ChenBri/claude-deck/DECISIONS.md

# claude-deck: decision log

A hand-built physical status panel for Claude Code. Lights, buttons, an animated
pixel-art screen and two analog needles, driven by Claude Code hooks.

## System

| # | Decision | Choice | Notes |
|---|---|---|---|
| 1 | Brain | Radxa ZERO 3W (RK3566, 2GB) | Full Linux. Header unpopulated, must be soldered. Amended 2026-09-23: was Raspberry Pi Zero 2 W, changed after checking eleven distributors including Israel's own official importer (piitel.co.il) and finding it out of stock everywhere, several with no restock date at all - a genuine global shortage, not a momentary gap. The Radxa is in stock on AliExpress today (an approved Radxa distributor) and is a spec upgrade, not a compromise: quad-core Cortex-A55 @ 1.6GHz vs. the Pi's A53 @ 1GHz, 2GB RAM vs. 512MB, WiFi 6/BT 5.4 vs. WiFi 4/BT 4.2. The whole pin map, the NeoPixel driver, and the power-in path had to be redone for the different SoC - see docs/HARDWARE.md. |
| 2 | PC link | USB gadget: HID keyboard + USB ethernet | Composite device. ECM for macOS, RNDIS for Windows. |
| 3 | Network | USB point-to-point only, WiFi behind a panel toggle | 10.55.0.1 to 10.55.0.2. Not on the LAN, not routable. |
| 4 | Power | Separate 5V 3A supply into PWR IN | Data port stays data-only. No backfeed, no current limits. |
| 5 | Filesystem | Read-only root with RAM overlay | Power loss can never corrupt the OS. |
| 6 | History | Third writable partition, /var/deck | Settings and stats. Written only on state transitions. |
| 7 | Shutdown | Long-press the encoder, plus a lit rocker on the back | Clean shutdown with a goodbye animation. |
| 8 | Stack | Python on the deck, TypeScript daemon on Windows and macOS | One daemon codebase, platform-specific action implementations. |
| 9 | Config | Encoder menu as the interface, YAML underneath | Regexes cannot be typed on a knob, so the menu writes the file. |

## Safety

| # | Decision | Choice |
|---|---|---|
| 10 | Button path | Daemon-verified. HID emits only F13-F20, never a printable key. |
| 11 | Approve semantics | "Approve request X", matched against what is on screen, 90s expiry. |
| 12 | Denylist | All four categories: database, destructive fs and git, infrastructure, secrets. |
| 13 | Machines | Full action set on Windows and on the Mac alike. The denylist, not a profile, is what protects production access. |
| 14 | Scrubbing | Truncate and redact before anything leaves the PC. |
| 15 | Audit | SQLite log on the PC of every deck-originated action. |

Full reasoning in [docs/SAFETY.md](docs/SAFETY.md).

## Panel

| # | Decision | Choice |
|---|---|---|
| 16 | Lamps | 5: READY, WORKING, BLOCKED, DONE, LINK |
| 17 | Legends | Backlit engraved acrylic strip, laser cut |
| 18 | Ambient | WS2812B strip for both the bezel halo and the underglow. Amended while sourcing: a circular ring does not fit a rectangular bezel, and 1m of 60/m strip covers the ~300mm halo perimeter and the ~300mm underglow with spare. |
| 19 | Meters | Two analog needles: CONTEXT and FIVE_HOUR. Amended 2026-09-21: originally CONTEXT and a vague "ACTIVITY", never actually wired to data. Redefined to CONTEXT (exact: current session's own token usage against the model's window) and FIVE_HOUR (an estimate: local token usage across the trailing 5 hours, weighted toward real cost since raw cache-read tokens massively overstate usage, against a budget you calibrate yourself, since Anthropic doesn't expose real remaining quota anywhere local). A third meter for weekly usage was considered and dropped: same estimate problem plus unverified panel space, not worth it for a number nobody can fully vouch for. See #58. |
| 20 | Display | 11.6 inch HDMI panel + driver board, 1366x768, in a recessed bezel. Amended 2026-09-22: was 2.4 inch IPS SPI, 320x240. Chen wanted a genuinely monitor-class screen (260x150-220mm), which a hobbyist SPI TFT does not make past ~4-5in - this is a real interface change (HDMI, not SPI), not just a bigger cutout. See docs/HARDWARE.md for the freed-up GPIO pins and the open question on the driver board's supply voltage. |
| 21 | Session selector | 6-position rotary switch, 1-5 plus ALL |
| 22 | Encoder | Menu, scrolling, long-press shutdown. Snake steering moved to the joystick. |
| 23 | APPROVE / DENY | 19mm illuminated metal pushbuttons, 3-6V ring LED, momentary self-reset, pre-wired. Live only when a prompt is pending. Amended while sourcing: illuminated arcade buttons were either unavailable outside bundle listings or 45mm, too large for the deck. |
| 24 | Panic | 22mm XB2-542 mushroom e-stop, 1NO1NC, **latching**. Amended while sourcing: spring-return mushrooms are not sold on AliExpress. Firmware fires on the press edge and holds an INTERRUPTED state until the twist-release, so the latched head visibly shows a killed run. Flip cover dropped as redundant. |
| 25 | Mech keys | 4: CLD (focus or launch), NEW, PLAN, MIC (push to talk) |
| 26 | Toggles | MUTE, NIGHT, AUTO-ACCEPT |
| 27 | Back panel | Panel-mount USB-C, barrel jack, lit rocker, SD cutout |

## Screen

| # | Decision | Choice |
|---|---|---|
| 28 | Style | Warm CRT phosphor UI, full-colour mascot, scanlines and slight bloom. Fixed 2026-09-27: the bloom was meant to add ~9% but pygame ignores set_alpha on BLEND_RGB_ADD blits, so it added 100% and doubled every colour (the orange palette rendered yellow). Now scaled explicitly, see `BLOOM_STRENGTH` in ui/render.py. |
| 29 | Art pipeline | Code-defined pixel grids rendered to PNG, refinable in Piskel |
| 30 | Mascot | Original starburst character, not Anthropic artwork |
| 31 | HUD | Session name, elapsed time, context bar |
| 32 | Ticker | Live tool name and target, sanitized |
| 33 | Idle dashboard | Clock, date, your name, weather from the daemon, git status of the last repo, today's totals. Superseded 2026-09-27 by #66: the same data now lives on ambient-mode cards, and the attract-mode snake is gone. |
| 34 | Games | Snake and Tetris as first-class scenes, launched from the encoder menu when idle. Joystick steers, mech keys rotate and drop, encoder push pauses. Amended 2026-09-25: 2048 and Pong added, same input conventions. All four now share a high score table (`deck/scores.py`, `${DECK_VAR}/scores.yaml`) with retro three-letter arcade-style initials entry on a qualifying game over (`deck/ui/name_entry.py`) - joystick up/down cycles the letter, left/right moves the slot, encoder push confirms. |
| 35 | DONE behaviour | Auto-clears back to READY after a few minutes |

## Sound

| # | Decision | Choice |
|---|---|---|
| 36 | Style | Chiptune blips generated in code, one per event |
| 37 | Events | Blocked, finished, error, task start and subagent spawn |
| 38 | Output | MAX98357A I2S amp, 40mm speaker, hard MUTE toggle |

## Enclosure

| # | Decision | Choice |
|---|---|---|
| 39 | Form | Retro terminal. Vertical face with a recessed CRT bezel, sloped control deck. |
| 40 | Size | 300 x 130 x 290 mm. Deck 55mm deep. Amended 2026-09-22 (twice): the original 160 x 120 x 100mm was never checked against actual component footprints. First pass: laying out real part sizes (the old 2.4in display, two 34mm meters, 5 lamps, rotary + encoder + 4 mech keys + 3 toggles + joystick + 4 Game Boy buttons + APPROVE/DENY + panic) with genuine finger-clearance came to roughly 250-280mm wide, landed on 260 x 120 x 150. Second pass: decision #20's display upgrade to an 11.6in monitor-class panel (257x144mm active area) leaves no room to flank it with the meters/lamps the way the small display's did, so those moved to a row below the screen instead, and the case grew again to fit the screen plus that row plus real bezel margin. |
| 41 | Colour | Matte black with orange accents |
| 42 | Process | FDM PETG via a print service. MJF nylon reprint later if wanted. |
| 43 | CAD | OpenSCAD, case as parametric code in this repo |
| 44 | Ballast | 3mm steel plate in the base plus rubber feet, about 1kg total |
| 45 | Fasteners | M3 brass heat-set inserts |

## Build

| # | Decision | Choice |
|---|---|---|
| 46 | Wiring | Perfboard first, custom PCB HAT as a later revision |
| 47 | Tools | Full soldering kit purchased new |
| 48 | Sourcing | AliExpress only, one order, everything at once. Case, legend strip, ballast plate and isopropyl fabricated or bought locally because they cannot be catalogue items. Amended 2026-09-23: no longer one order. AliExpress still covers the bulk (sections A-J), the genuine ICs come from Digi-Key (counterfeit risk), and the microSD from KSP (was piitel.co.il, same day - same real card, better price, physical Israeli branches; AliExpress never worked for it, fake-capacity listings only). A same-day check into moving the ICs to Farnell Israel too was reverted: no real domestic-sourcing benefit over Digi-Key (both are localized storefronts shipping internationally, not local warehouses) and it would have forced an SMD substitute for one part. Three orders, not one - see docs/BOM.md. |
| 49 | Sequencing | Software and simulator now, single order in parallel, one build when it all lands. No early partial build. |
| 50 | Budget | No hard ceiling. Landed at roughly $416 all-in including every tool, now ~$453 after the joystick, Game Boy buttons, the display's jump to an 11.6in HDMI panel (and the 12V power rework that forced), the effort dial, and the volume knob - see docs/BOM.md for the running total. |
| 51 | MIC key | Daemon receives the hotkey and invokes the OS dictation shortcut: Win+H on Windows, the configured dictation shortcut on macOS. |
| 52 | Fabrication | Local Tel Aviv print shop for the PETG case and the laser-cut legend strip, ordered after the electronics arrive so every cutout is measured. |
| 53 | Joystick | KY-023 analog thumbstick read through an ADS1115 I2C ADC, push button on the second MCP23017. Added 2026-09-21 for games and menu navigation. The deck gains a ~26mm square cutout; case width may grow to 170mm. |
| 54 | Game Boy app | PyBoy (GB/GBC) headless core, added 2026-09-21. Home-screen app alongside Settings/Snake/Tetris/2048/Pong (see #34). Draws into its own 160x144 canvas (native GB resolution), letterboxed onto the panel instead of the 160x120 canvas every other scene shares. |
| 55 | Game Boy buttons | A, B, START, SELECT: four Gateron G Pro switches with DSA keycaps, the same part already used for CLD/NEW/PLAN/MIC, not 6x6mm tactile buttons. Amended 2026-09-21: the deck is a stationary desk instrument, not something you hold, so "comfortable like a real Game Boy" means real switch travel and a real layout, not just wiring four more contacts to spare pins. A/B sit in a diagonal offset (A upper-right, B lower-left) rather than a row; START/SELECT are a smaller pair off to the side. Wired to the second MCP23017's remaining spares, no new IC. The d-pad reuses the existing joystick rather than adding a fifth control. |
| 56 | ROM handling | Never shipped in this public repo: each person drops their own legally-dumped .gb/.gbc files into firmware/roms/, which is gitignored except for its own README. Planned, not yet built: a fifth USB gadget function (mass storage, backed by a FAT image file on the writable partition, toggled from the Settings app) so ROMs can be dragged onto the deck as a drive from the connected PC instead of swapping the SD card. No hardware exists yet to build this against; see docs/HARDWARE.md. |
| 57 | Game Boy audio | No new hardware: PyBoy's emulated audio is queued onto the existing `chiptune` mixer (now stereo) through a channel it reserves so a running game's stream and the deck's own event blips never steal each other's channel. Same MAX98357A amp and speaker, same MUTE toggle. |
| 58 | Meter data source | CONTEXT and FIVE_HOUR both come from Claude Code's own local session logs under `~/.claude/projects`, the same files a tool like ccusage parses, never from an Anthropic API (none exists for this). The daemon reads the active session's own transcript for CONTEXT (exact) and scans every project's transcripts in the trailing 5 hours for FIVE_HOUR (an estimate, weighted toward Anthropic's approximate real pricing so cache reads don't dominate the number and pin the gauge at 100% within one long session, which the naive raw-token-count version did in testing). The weighting and the budget it's compared against are both best-effort and need calibrating to your own plan; see `daemon/src/enrich/usage.ts` and `DECK_FIVE_HOUR_TOKEN_BUDGET` in README.md. |
| 59 | Effort dial | A second SR16-family rotary switch (same part as the session selector, decision 21), 5 of its 6 positions wired: LOW/MEDIUM/HIGH/XHIGH/MAX. Added 2026-09-22 once the display upgrade's wider deck left real room for it. Wired to MCP23017 #2's spares, no new IC. Amended same day: what the daemon does with it is a real, confirmed mechanism, not the placeholder it started as - it types Claude Code's own `/effort <level>` slash command into the terminal (`effortSelect` in `daemon/src/actions/`), the same class of action as the existing approve/deny keystrokes. See decision 63 for `planMode()`, which had the same problem and is now fixed the same way. |
| 60 | Volume knob | A standalone panel-mount potentiometer (not the joystick's KY-023 pots), into the ADS1115's other spare channel (A2). Independent of the MUTE toggle: the knob sets the level, MUTE is a hard override to silent regardless of where it's turned. Purely local to the deck - chiptune.py's mixer, no daemon round-trip needed. Sourced 2026-09-22: RV24YN20S 10K ohm, real 24mm panel-mount part, ₪4.22 for a set of 3 with the A03 knob and dial plate included - cheaper than the placeholder guessed, with 2 spares free. |
| 61 | Speaker grille | Cosmetic: a small perforated patch either side of the lamp row, in what was otherwise dead space between the lamps and each meter. Ties the existing speaker into the retro-radio look instead of hiding it behind a blank face. No BOM cost, no new part. |
| 62 | Main power rail | 12V, not 5V. Amended 2026-09-22: sourced a real 11.6in display listing (docs/BOM.md B1, ₪145.48, Heyman Store) and confirmed its driver board wants 12V 2A, DC 5.5mm - not the 5V this whole design was built around. Rather than run two power cords into the case, one 12V input now feeds the display directly and a small buck converter steps it down to 5V for the deck/PCA9685/MCP23017s/amp, unchanged otherwise. Recommend a 12V 3A supply. Side effect: the KCD1 rocker switch's 12V-rated LED, previously dim on the 5V rail, now runs at full brightness with no mod, wired ahead of the buck converter. |
| 63 | PLAN mech key | Fixed 2026-09-23, same class of gap as decision 59's effort dial: `planMode()` sent a guessed hotkey (Alt+P / Option+P) that launched nothing real. The actual mechanism, confirmed against code.claude.com/docs/en/permission-modes, is Shift+Tab cycling the CLI's permission mode (`default` -> `acceptEdits` -> `plan` -> back to `default`, 3 presses from `auto`), which is relative to the session's current mode rather than a fixed key. The daemon now tracks each session's last-seen `permission_mode` from the hook payload (`sessions.ts`) and computes the exact Shift+Tab count in `guard.ts`; an unknown or uncyclable mode (`dontAsk`, `bypassPermissions`) sends nothing, same "don't guess a keystroke" rule as the approve button. The deck now tags the `mech_key` action with the active session id so the daemon knows whose mode to read. |
| 64 | Info rails | The 160x120 canvas letterboxed onto the 16:9 panel left two ~170px black bars. They now hold two 26x120 pixel rails at the same scale and CRT pass: left is clock, date, weather; right is state, session count, and CONTEXT/FIVE_HOUR as bars. Shown over every scene including games, so a glance always gives time and state. Rendering only, nothing in the state machine or approval path reads them. |
| 65 | Screen at night | The NIGHT toggle now dims the screen too (`night_screen`, default 0.4), not just the lamps. Quiet hours (default 01:00 to 08:00, Settings) blank the screen, but only in a calm state (READY, DONE, IDLE, OFFLINE) and only after 3 minutes without a touch. Anything that wants you or shows live work lights it regardless of the hour. Time comes from the daemon's idle payload since the board has no RTC and no internet, falling back to the deck's own clock. Blank is a black frame; the panel's backlight is still on, since the driver board exposes no control for it. |
| 66 | Ambient mode | The screen is mostly looked at while nothing needs you, so calm states get their own content. IDLE shows it straight away; READY and DONE drift into it after 60s without an event (DONE keeps its confetti first). It rotates data cards (clock, weather, today's usage, git, a 5-hour chart against even pace), 20s each, with a 60s mascot-life scene after every two; an encoder turn skips. Cards with no data are skipped, never shown empty. Rendering only: SceneManager re-decides every frame, so anything that wants you takes the screen back on the next frame, and the state machine, lamps, LEDs and approval path never see ambient mode. The daemon's idle payload grew `today` (sessions, tool calls, approvals, denials, turns, output tokens) and `five_hour_series`, from the same single transcript scan that already fed the FIVE_HOUR meter. |
| 67 | Mascot life | The mascot scene in ambient mode is one small room that changes with the local hour: coffee at a table (06-11), wandering between the plant and the window (11-15), reading (15-19), watching the night sky (19-23), asleep with floating Zs (23-06). Props are code-defined grids on the mascot's own 4px cell (#29), so the room shares one pixel grid. Every animation is a pure function of the clock, so re-entering ambient never resumes a half-finished animation. Also fixed on the way: the READY blink overrode the eye whites next to the pupils instead of the pupils themselves, so the mascot never actually closed its eyes. |
| 68 | PCA9685 output mode | Open-drain (MODE2 OUTDRV = 0), found 2026-09-27 while planning the real panel driver. The chip's logic supply must be 3.3V (its I2C pull-ups share VCC and the Radxa's pins are 3.63V max), so a totem-pole "high" is only 3.3V: lamps sinking from 5V would glow faintly when off, and the meters' 5V drive maths wouldn't hold. Open-drain makes an off channel high-impedance, so all LED loads sink cleanly from 5V; each meter gets a 1k pull-up to 5V and its duty is inverted in software. No new parts, the pull-ups come from the resistor kit. See docs/HARDWARE.md. |
| 69 | HID and HTTP pairing | Closes the gap between SAFETY rules 1 and 2: an F13 key proves a physical press but can't say which request, and the HTTP action names the request but could come from anything on the link. The daemon now runs approve, deny and the mech keys only when both halves arrive within 1s (`daemon/src/link/pairing.ts`); an unpaired half is dropped and audited. PANIC runs on either half alone, since it can only stop things. Hotkeys come from a small per-OS helper process: RegisterHotKey on Windows (tested end to end with a real F13 press), Carbon RegisterEventHotKey on macOS (written, untested until there's a Mac). `DECK_REQUIRE_HID=0` exists for the simulator only. Also fixed on the way: mech keys pressed inside a game were forwarded to Claude, so dropping a Tetris piece with NEW started a new session. |
| 70 | Deck provisioning | `deploy/`: one idempotent `setup.sh` on Radxa's Debian CLI image. The firmware runs as an unprivileged `deck` user with udev access to exactly its four device nodes, and one sudoers line for poweroff (the encoder long press now actually powers off). App and venv live on the writable DECKDATA partition at `/var/deck`, so updates (`deploy.ps1`, over the USB link) never touch the read-only root, which is overlayroot on tmpfs. The USB link's DHCP comes from systemd-networkd, one address, no router or DNS. SSH listens on the link only, keys only. WiFi and Bluetooth are rfkill-blocked at boot. The HID gadget's report descriptor declares only F13 to F20, so the host itself discards any other keycode. The setup script never partitions; the data partition is a manual step before first boot. |
| 71 | WiFi toggle | Settings > wifi radio now does something: it runs `rfkill unblock|block wifi` through a sudoers entry allowing exactly those two commands, and is re-applied at start-up because `deck-radio-off` blocks WiFi on every boot. There is no physical WiFi switch in the BOM, so non-negotiable 4 now reads "blocked at boot, on only through Settings", and the right rail wears a red frame and a WIFI tag for as long as it's on, since it's the one way the deck gets a route out. If rfkill refuses, the setting reverts rather than lying. Bluetooth stays blocked, no toggle. |

## Hardware constraints resolved

- **Pin budget.** I2S audio claims GPIO18/19/21, which kills SPI1 and PCM.
  NeoPixels therefore run on GPIO12 (PWM0) via `rpi_ws281x` as root in a systemd
  service. Display on SPI0. Lamps and both meters offloaded to a PCA9685 on I2C.
  Rotary switch, mech keys and toggles offloaded to an MCP23017. Buttons and the
  encoder stay on real GPIO for latency.
- **Logic levels.** 74AHCT125 between the deck's board and the WS2812B data line.
- **No analog output.** Meters driven by PCA9685 PWM through an RC filter with a
  calibration trimpot each.
- **Power.** 2.08A peak, so a 5V 3A supply.

Details in [docs/HARDWARE.md](docs/HARDWARE.md).
