ChenBri/claude-deck/docs/ARCHITECTURE.md

# Software architecture

```
Claude Code session(s)
   |  hooks: SessionStart, UserPromptSubmit, PreToolUse, PostToolUse,
   |         Notification, Stop, SubagentStop, PreCompact, SessionEnd
   v
hooks/emit.js  -- POST 127.0.0.1:7327 -->  daemon  (TypeScript, Win + macOS)
                                              |  scrub, classify, aggregate
                                              |  HTTP over USB ethernet 10.55.0.1
                                              v
                                    firmware (Python, Radxa ZERO 3W)
                                              |
                              panel backend: real  |  sim
```

## Daemon, TypeScript, runs on Windows and macOS

One codebase, one binary per platform, same behaviour. Responsibilities:

- **Ingest.** Local HTTP endpoint the hook scripts POST to. Hooks stay trivial
  one-liners so they add no measurable latency to your session.
- **Scrub.** Truncate and redact before anything leaves the machine. See SAFETY.md.
- **Classify.** Map raw events onto deck states. Run the denylist over pending
  permission requests and mark each approvable or not.
- **Aggregate.** Track every live session. Serve either the one the rotary switch
  selects, or the highest-priority state across all of them when set to ALL.
- **Act.** Receive button events, verify them against the rules, then focus the
  right window and perform the action. Windows via Win32 calls, macOS via
  AppleScript and Accessibility.
- **Enrich.** Push weather, clock and git status for the idle dashboard, since
  the deck has no internet.
- **Audit.** SQLite log of every action the deck took.

```
daemon/src/
  index.ts          bootstrap, host detection for the action backend
  http.ts           hook ingest endpoint
  scrub.ts          redaction and truncation
  classify.ts       event -> state, denylist evaluation
  sessions.ts       multi-session registry and priority
  guard.ts          approval verification rules
  link/
    transport.ts    HTTP to the deck over the USB link
    hotkeys.ts      F13-F20 global hotkey registration
  actions/
    windows.ts      focus, send keys, launch
    macos.ts        same, via osascript
  enrich/           weather, git status, Claude Code's own local usage logs (the two meters)
  store.ts          SQLite audit log
```

## Firmware, Python, runs on the deck

```
firmware/deck/
  main.py             event loop
  state.py            state machine, priority, latching, timeouts
  link.py             talks to the daemon, heartbeat drives the LINK lamp
  hid.py              USB HID gadget writer, F13-F20 only (SAFETY.md rule 1)
  menu.py             encoder-driven settings menu, writes /var/deck/settings.yaml
  hwtest.py           bench bring-up: live input readout, output sweep (Settings)
  calibration.py      per-meter 5-point needle curve and its wizard (Settings)
  screen.py           NIGHT dimming, quiet-hours blanking, daemon-sourced wall clock
  panel/
    base.py           abstract Panel: lamps, meters, pixels, inputs, screen surface
    real.py           wires the hw/ drivers to docs/HARDWARE.md's pins and channels
    hw/               PCA9685 (open-drain), MCP23017, ADS1115, WS2812-over-SPI,
                      gpiod edges; input decoding kept pure and tested with fakes
    sim.py            pygame window drawing the whole panel on your desktop
  ui/
    render.py         scene compositor, dirty-rect blitting, CRT post effect
    rails.py          clock/weather and state/meter rails in the letterbox bars
    cards.py          ambient data cards: clock, weather, today, git, 5-hour chart
    sprites.py        code-defined pixel grids -> PNG sprite sheets
    scenes/
      ready.py        sits, blinks, stretches
      working.py      types at a tiny desk, glyphs fly, speed tracks tool-call rate
      subagents.py    one mini mascot per live subagent
      blocked.py      turns, looks at you, holds a question sign
      done.py         victory hop and confetti
      compacting.py   sweeps papers into a box
      ambient.py      calm-state rotation: data cards and mascot life (IDLE, quiet READY/DONE)
      life.py         what the mascot gets up to, by time of day
      snake.py        joystick steers, encoder push pauses
      tetris.py       joystick moves, mech keys rotate and drop
      breakout.py     encoder detents move the paddle, joystick too
      gameboy.py      PyBoy (GB/GBC) core, own 160x144 canvas, letterboxed
      boot.py         covers the ~25s boot so it never looks broken
  audio/
    chiptune.py       generated blips, one per event, mute switch respected;
                      swappable themes (classic, soft, arcade, minimal);
                      also owns the mixer for the Game Boy app's streamed audio
    cues.py           which state change plays which blip
```

## The simulator

`SimPanel` implements the same interface as `RealPanel` and renders the entire
front panel into a pygame window: five lamps, both needles, the NeoPixel halo and
underglow, the arcade buttons, the toggles, the rotary switch. Mouse clicks and
keyboard shortcuts drive the inputs.

The screen area inside the simulated bezel runs the **exact same rendering code**
as the real display. Nothing about the animation, the scenes, the timing or the
snake game is written twice.

```bash
python -m deck.main --panel sim
```

This means the software is finished and tuned before any part arrives, and the
project stays testable in CI forever.

## States

| State | Entered by | Lamp | Screen |
|---|---|---|---|
| `READY` | SessionStart, Stop | READY | mascot sits, blinks |
| `WORKING` | UserPromptSubmit, PreToolUse | WORKING | typing, glyphs, speed tracks tool rate |
| `SUBAGENTS` | PreToolUse on Task | WORKING | one mini mascot per live subagent |
| `BLOCKED_PERMISSION` | Notification, permission variant | BLOCKED | turns to face you, question sign |
| `BLOCKED_INPUT` | Notification, idle variant | BLOCKED | taps foot, checks watch |
| `COMPACTING` | PreCompact | WORKING | sweeping papers |
| `DONE` | Stop after work | DONE | victory hop, confetti, auto-clears |
| `ERROR` | PostToolUse failure, SessionEnd error | BLOCKED | storm cloud |
| `IDLE` | no session for N minutes | none | ambient mode: data cards and mascot life |
| `OFFLINE` | daemon heartbeat lost | LINK dark | connection lost card |

Aggregation priority when the selector is on ALL:

```
BLOCKED_PERMISSION > BLOCKED_INPUT > ERROR > WORKING > SUBAGENTS
                   > COMPACTING > DONE > READY > IDLE
```

`DONE` auto-clears back to `READY` after a few minutes, per the chosen behaviour.

## Rendering

- Logical canvas 160x120. Used to be an exact 2x fill of a 320x240 SPI panel;
  the display is a 1366x768 HDMI panel now (DECISIONS.md #20), so
  `compose_output` scales the canvas up to the largest size that still fits
  (6.4x, 1024x768) and letterboxes the rest, rather than an exact multiple.
  The Game Boy app hands in its own 160x144 canvas (native GB resolution)
  and gets the same treatment. Pixel art stays crisp either way; the
  tradeoff is unused width as black bars rather than a stretch.
- Dirty-rect blitting: the mascot moves, the background does not.
- A light CRT post pass, scanlines and slight bloom, to sell the enclosure.
- Target 20 to 30 fps on a Zero 2 W, which is above classic handheld animation.

## Sprites

Sprites are authored as code-defined pixel grids in `sprites.py` and rendered to
PNG sheets at build time. They live in the repo as both source and output, so
they are diffable, regenerable, and any frame can be opened in Piskel or Aseprite
and hand-tweaked.

The mascot is an original pixel character based on a starburst silhouette. It is
not Anthropic artwork.

## Testing

- `pytest` over the state machine, which is pure logic and decides when the
  approve button is live. It gets real tests.
- `tools/record.py` captures live hook events from your normal work into JSONL.
- `tools/replay.py` plays a recorded session into the simulator at up to 10x, so
  every transition is tuned against how you actually work.
