ChenBri/claude-deck/(commit log)

2026-09-20 Full spec: hardware, architecture, safety model, BOM and build plan
2026-09-20 BOM: record verified AliExpress variant trap
2026-09-20 Three-source plan, Digi-Key CSV, real meter spec from the ordered part
    [digikey-bom.csv]
2026-09-20 Cart at 9 lines with verified prices; flag arcade button sourcing problem
2026-09-20 Approve/Deny become 19mm illuminated metal pushbuttons; cart at 11 lines
2026-09-20 Cart at 24 lines; 2.54mm kit replaces JST-XH, wire is 22AWG
2026-09-20 Tools in cart: soldering kit, solder, multimeter, crimper, pliers. 29 lines, 738 ILS
2026-09-21 Phase 0 software: firmware simulator, state machine, and daemon
    firmware/: state machine (priority, DONE auto-clear, panic latch, 90s
    approval expiry) with full pytest coverage; SimPanel drives the whole
    front panel in pygame (lamps, meters, 30 NeoPixels, buttons, panic
    mushroom, toggles, rotary, encoder, mech keys, joystick); scene
    compositor with a shared CRT compose pass and one scene per state plus
    Snake and Tetris; encoder settings menu; tools/record.py and
    tools/replay.py for phase-0 hook recording ahead of hardware.
    daemon/: hook ingest, scrub, classify, denylist (all four SAFETY.md
    categories), per-session pending-request tracking, and the approve/deny
    guard with a SQLite audit log;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
2026-09-21 Fix rotary switch: assign fixed 1-5 slots to sessions
    SessionRegistry.aggregate() looked up the selector directly as a session
    id, so rotary positions "1".."5" never matched anything (real session
    ids are UUIDs, not "1"). Individual-session selection was silently
    broken; only ALL worked.
    Now each session gets the first free slot (1-5) on arrival and keeps it
    until dropped, so switching position never gets reassigned just because
    some unrelated session elsewhere ended. Added SessionRegistry.prune()
    to free slots held by sessions nobody's touched in a while, wired into
    main.py's loop every 30s.
    [sim.py, test_state.py]
2026-09-21 Wire WORKING scene animation speed to real tool-call rate
    SessionState now tracks PreToolUse timestamps in a trailing 10s window
    and exposes tool_call_rate(); main.py passes it into Context instead of
    the previous always-0.0 default, so the mascot's typing speed and flying
    glyphs actually track how fast tool calls are coming in.
2026-09-21 Wire NIGHT toggle to actually dim lamps and button LEDs
    NIGHT flipped a toggle event with nothing listening. Panel.set_button_led
    now takes a 0..1 level instead of a bool (0 = dead, matching the existing
    "live only while pending" semantics), and App tracks night_on plus a
    _brightness() helper reading menu.settings["night_brightness"].
    Deliberately does not touch set_meter(): those PCA9685 channels are the
    needle position itself (docs/HARDWARE.md), not a backlight, so dimming
    them would falsify the CONTEXT/ACTIVITY reading rather than just make it
    dimmer to look at.
    [base.py, real.py, sim.py]
2026-09-21 Drive the NeoPixel halo/underglow; forward denylist toggles from the menu
    set_pixels() was never called by anything: the halo/underglow just sat
    dark regardless of state. ui/pixels.py ties ambient color to whichever
    lamp state is live, with a breathing pulse for BLOCKED/ERROR/INTERRUPTED
    per docs/HARDWARE.md's "blocked-state pulse", and respects NIGHT's
    brightness like the lamps do.
    Also wires the encoder menu's denylist.* toggles (previously local-only,
    written to settings.yaml and nowhere else) to forward each change to the
    daemon over the link as a denylist_toggle action, plus a best-effort
    full sync on startup so a freshly restarted daemon picks up whatever was
    last set rather than fall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
    [test_pixels.py]
2026-09-21 Sim: 1.6x readable zoom; link: bind failures degrade instead of crash
    Widget labels (lamps, buttons, toggles, rotary, encoder, mech keys,
    joystick) were unreadably small in the actual window. SimPanel now
    draws everything onto a native-resolution surface as before, then
    zooms the whole composited frame 1.6x into the real OS window - a
    desktop-only presentation change, so it never touches compose_output()
    or anything shared with the real 320x240 hardware display. Click
    hit-testing unzooms mouse coordinates before matching hitboxes.
    Also: DaemonLink previously bound its HTTP server directly in __init__,
    so pointing it at an address that doesn't exist yet (the real hardware
    IPs, before hardwar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
    [sim.py]
2026-09-21 Fix illegible screen text: wrong font choice, not the CRT effect
    Root-caused the "can't read anything on screen" report by isolating
    each layer: at zero CRT postprocessing, small text was still mush.
    The actual cause was gfx.draw_text using pygame's default proportional
    TrueType font with antialiasing off - fine for the pixel-art mascot's
    solid color fills, but that combination renders small UI text (the
    ticker, the settings menu) as broken, uneven glyphs almost regardless
    of point size. Switched to a monospace system font (Consolas / DejaVu
    Sans Mono / Courier New / generic monospace, first available) with
    antialiasing on; verified side by side that this alone fixes it.
    Also genuinely tune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
2026-09-21 Add a phone-style app launcher; fix Snake/Tetris game-over dead end
    Root cause of "stuck after game over": once game_over was True, both
    games' _step()/_handle_input() returned early forever with no way to
    reset or exit, and there was no way to leave a game screen at all
    except a live session stealing focus back. Two fixes:
    1. Encoder push while game_over now retries (calls _reset()) instead
    of toggling pause, which did nothing once game_over anyway.
    2. New home screen (deck/apps.py + ui/scenes/home.py): encoder push
    while idle opens it, showing every registered app as an icon row.
    Joystick left/right moves the highlight, encoder push launches, and
    joystick push is now a univers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
2026-09-21 Document joystick hardware: KY-023 + ADS1115, second MCP23017
    Records decision 53 and the I2C address map for the joystick already
    wired into Snake/Tetris.
2026-09-21 Add a Game Boy / GBC app: PyBoy core, dedicated A/B/Start/Select input
    Fourth home-screen app, alongside Settings/Snake/Tetris. Runs PyBoy
    headless and draws straight into its own 160x144 canvas (native GB
    resolution) instead of the shared 160x120 one; ui.render.compose_output
    is generalized to scale whatever canvas size it is handed to fit the
    physical panel, letterboxed, so every other scene is unaffected (still
    an exact 2x fill).
    Joystick doubles as the d-pad. A/B/Start/Select are new dedicated
    buttons (panel.base.GB_BUTTONS), fed through the same continuous
    press/release path a real MCP23017 poll would give rather than a
    one-frame edge, so held inputs (e.g. run in Mario) work. Encoder r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
2026-09-21 Document the Game Boy app: decisions, wiring, BOM, and a ROM-drive plan
    Records decisions 54-56, MCP23017 #2's A/B/START/SELECT wiring, a BOM
    line for the four tactile buttons (unsourced placeholder price), the
    architecture note on per-app canvas sizes, and the planned USB mass
    storage gadget function for dragging ROMs onto the deck from the
    connected PC. That last part isn't implemented: no hardware exists yet
    to build the gadget config against, same status as RealPanel.
2026-09-21 Wire sound into the Game Boy app, and pace emulation to real time
    PyBoy's raw stereo samples queue onto chiptune's mixer, which is now
    stereo with channel 0 reserved so a running game's audio and the
    deck's own event blips never steal each other's channel. Respects the
    existing MUTE toggle, no new hardware: same MAX98357A amp and speaker
    every other sound already uses.
    Also fixes a real bug this surfaced: tick() doesn't pace itself to
    real time (confirmed it free-runs at ~3000fps headless), so a single
    tick() per drawn frame was running the game in slow motion relative
    to a wall clock. The scene now ticks in step with elapsed real time,
    capped so a lagged frame can't spiral into catch-up, a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
2026-09-21 Redo Game Boy buttons as real switches in a real layout, not tact buttons
    A/B/START/SELECT were spec'd as 6x6mm tactile pushbuttons, cheap and
    easy to wire but closer to a router reset button than something you'd
    want to mash under a thumb. Switched to the same Gateron G Pro switch
    and DSA keycap already bought for CLD/NEW/PLAN/MIC: the verified
    cart's 10-pack and 20-pack already cover all eight (only 4 of each
    were spoken for), so this is a zero-new-sourcing swap, not a new BOM
    line. Laid out like the real thing too: A/B diagonally offset instead
    of a row, START/SELECT a smaller pair off to the side. Updated the
    sim's drawn layout to match and verified it renders with no
    overlapping labels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
    [sim.py]
2026-09-21 Wire the two panel meters to real data: CONTEXT and FIVE_HOUR usage
    Fixes a real bug on the way: set_meter() was never called anywhere,
    same class of bug as the NeoPixels earlier in this project - the
    meters existed but nothing ever drove them.
    CONTEXT is exact: the daemon reads the active session's own
    transcript under ~/.claude/projects and reports how much of the
    model's context window the most recent turn actually used. FIVE_HOUR
    replaces the never-defined "ACTIVITY" meter with an estimate: total
    token usage across every project's transcripts in the trailing 5
    hours, against a budget you calibrate yourself, since Anthropic
    doesn't expose real remaining quota anywhere a local process can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
    [base.py]
2026-09-21 Start the case CAD: parametric shell silhouette, stage 1 of the enclosure
    Provisional per DECISIONS.md #49/#52: real fabrication dimensions come
    after the electronics arrive, this is a visualization pass. Just the
    outer wedge silhouette so far (low front apron, sloped control deck,
    tall rear face), no wall thickness or cutouts yet - checking overall
    proportions before building anything on top.
    Flags one real ambiguity in DECISIONS.md #40 rather than quietly
    picking a number: "upper face 95mm, deck 55mm deep" doesn't fully
    resolve once the deck has to rise to a usable knob height without
    exceeding the 100mm case height. This model prioritizes a comfortable
    deck slope over hitting 95mm litera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
    [case.scad]
2026-09-21 Case CAD stage 2: every cutout, front face through back panel
    Display bezel, halo groove, 5 lamps, 2 meters, legend strip on the
    rear face; rotary switch, encoder, 4 mech keys, 3 toggles, joystick,
    4 Game Boy buttons, APPROVE/DENY, panic on the sloped deck; USB-C,
    barrel jack, rocker switch, SD slot on the back. Stand-in knobs and
    keycaps so it reads as a control panel, not just a box with holes.
    Pulled the deck's rise back from 52mm to 25mm: laying out the display
    stack (display + lamps + legend + meters + halo) on a face that was
    only 48mm tall was genuinely too tight, concrete evidence the face
    needs to be closer to DECISIONS.md #40's original 95mm than the first
    pass's ergonomic-only re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
    [case.scad]
2026-09-21 Rescale the case to real component footprints: 260x120x150, not 160x120x100
    Chen caught this: the render looked tiny, and it was right to. The
    original 160x120x100mm (DECISIONS.md #40) was never checked against
    actual part sizes. Redid the math from the real BOM/HARDWARE.md
    dimensions with genuine finger-clearance, not bare-minimum spacing,
    and the honest number is ~250-280mm wide. Agreed on 260 wide with
    Chen directly, plus more height than the math alone called for.
    Rebuilt every position in case.scad at the new scale rather than
    patch the old cramped layout again - control-deck clusters (rotary,
    encoder, mech keys, toggles, joystick, Game Boy buttons, APPROVE/
    DENY, panic) and the front-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
    [case.scad]
2026-09-21 Display upgraded to an 11.6in HDMI monitor panel, not an SPI TFT
    Chen wanted a genuinely monitor-class screen (260x150-220mm), which
    isn't an SPI display at all past ~4-5in - this is a real interface
    change (HDMI + driver board), not just a bigger cutout. 1366x768,
    257x144mm active area, a common cheap laptop-panel size.
    Ripples handled end to end rather than left inconsistent:
    - case.scad: screen dominates the face width now, so the meters/
    lamps/legend moved to a row below it instead of flanking it. Case
    grew to 300x130x290 to fit the screen, that row, and real bezel
    margin (DECISIONS.md #40, amended a second time).
    - render.py: OUTPUT_WIDTH/HEIGHT are the real 1366x768 panel now,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
    [case.scad]
2026-09-21 Add the effort dial, volume knob, and speaker grille
    Three picks from a brainstorm on the room the display upgrade opened
    up on the deck. All wired to already-provisioned spare capacity, no
    new ICs:
    - Effort dial: a second SR16 rotary switch (same part as the session
    selector), 4 of 6 positions wired to LOW/MED/HIGH/MAX, on MCP23017
    #2's spares. Sends a labelled action to the daemon; the actual host
    action it triggers (effortSelect in daemon/src/actions/) is a
    placeholder hotkey in the same spirit as the existing planMode() -
    there's no confirmed way yet to change Claude Code's reasoning
    effort from an external keystroke, flagged rather than guessed at.
    - Volume knob: a standalo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
    [case.scad]
2026-09-21 Source the real display, and rework power around what it actually needs
    Checked a real AliExpress listing (Heyman Store, 11.6in 1366x768
    HDMI/Type-C panel + driver board) rather than leave the display as a
    placeholder price. Confirmed two things that change real design
    decisions, not just a number:
    - Price: NIS145.48, landing at $40, close to the earlier $30-45
    guess but now a real checked price, not a guess.
    - Voltage: 12V 2A, DC 5.5mm - not 5V, which the whole rest of this
    design runs on. That's not a detail, it changes which rail is
    primary.
    Rather than run two power cords into the case, reworked around a
    single 12V input: the display taps it directly, a new buck converter
    (docs/B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
2026-09-21 Wire the effort dial to a real, confirmed mechanism: /effort
    Looked it up properly instead of shipping the placeholder hotkey
    guess. Claude Code has a real, documented slash command for changing
    reasoning effort mid-session: /effort <level>, with five real levels
    - low, medium, high, xhigh, max - not the four I'd arbitrarily picked
    (LOW/MED/HIGH/MAX) before checking.
    Fixed both things this surfaced:
    - The daemon's effortSelect() now types the actual /effort <level>
    command into the terminal (same class of action as the existing
    approve/deny keystrokes), not a guessed Alt+number hotkey. Real
    mechanism, not a "tune this locally" placeholder like planMode()
    still is.
    - The dial itself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
    [case.scad]
2026-09-21 Source the real volume knob potentiometer
    Checked a real listing instead of leaving the placeholder $1 guess.
    RV24YN20S, 10K ohm, real 24mm panel-mount part (same nut-and-bushing
    mounting as the rotary switches, not a PCB-mount type) - genuinely
    well-established (10,000+ sold, 4.9 stars, 458 reviews), a real
    buyer review confirms the knob and dial plate come included, and
    another did their own multimeter check on resistance tolerance.
    Sold as a set of 3 for NIS4.22, cheaper than the placeholder and
    with 2 spares for free. Updated docs/BOM.md's cart total, section E,
    and the master totals table; DECISIONS.md #60 and docs/HARDWARE.md's
    volume knob section now cite the real part.
    Co-Authored-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
2026-09-21 Hollow out the case: real 3mm wall thickness, not a solid block
    Every previous stage was solid apart from wherever a cutout happened
    to leave material - this makes the whole shell a real shell. Same
    profile drives both the outer silhouette and the cavity (offset() by
    wall thickness), so they can't drift out of sync as dimensions change
    above; the cavity's own width-direction extrusion is inset by wall on
    both ends too, so the left/right end caps get proper wall thickness,
    not just the front/back/top/deck-slope profile.
    Bottom stays open on purpose, not an oversight: DECISIONS.md #44 puts
    a 3mm steel ballast plate there as the actual base, not a printed
    floor, so the cavity extends past the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
    [case.scad]
2026-09-27 Track part arrivals in the BOM
2026-09-27 Swap brain from Raspberry Pi Zero 2 W to Radxa ZERO 3W
    The Pi Zero 2 W is out of stock everywhere, including Israel's official
    importer, with no restock date - a real shortage, not a momentary gap.
    The Radxa ZERO 3W is a spec upgrade (quad-core A55 vs single A53, 2GB vs
    512MB RAM) and in stock today. Redoes the pin map, moves NeoPixels from
    rpi_ws281x/PWM to a bit-banged WS2812-over-SPI driver, and moves power-in
    from a dedicated PWR port to the GPIO header's 5V pins.
    Also: sources the microSD from KSP instead of piitel.co.il (real branches,
    same card, better price), reverts a same-day detour to source the genuine
    ICs from Farnell Israel instead of Digi-Key (no real domestic-sourcing
    benefi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
    [digikey-bom.csv]
2026-09-27 Add 2048 and Pong, and a shared high score table for all four games
    Snake and Tetris had no score tracking at all; both get it here too, so
    "high scores" actually covers every game, not just the two new ones.
    deck/scores.py persists top-5-per-game to ${DECK_VAR}/scores.yaml, same
    load/save shape as deck/menu.py's settings.yaml. deck/ui/name_entry.py is
    the retro arcade-style initials entry that shows up on a qualifying game
    over: three letters, joystick up/down cycles the current one, left/right
    moves between slots, encoder push confirms.
    2048 is joystick-edge swipes with standard merge rules. Pong is single
    player against a deliberately-beatable AI paddle, continuous joystick
    y-axis inste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
2026-09-27 Add hardware test, meter calibration, Breakout and sound themes
    Hardware test and calibration live in Settings and work while OFFLINE so
    they are usable on the bench before the daemon is up. Event sounds were
    never played; they now fire on state changes through the chosen theme.
2026-09-27 Add info rails in the letterbox bars, night dimming and quiet hours
    Also fixes the CRT bloom, which doubled every colour because pygame
    ignores set_alpha on BLEND_RGB_ADD blits, and the daemon's idle date,
    which was UTC and read as yesterday after local midnight.
    [base.py, real.py, sim.py]
2026-09-27 Add ambient mode: data cards and a mascot slot for calm states
    IDLE goes straight to it and quiet READY/DONE drift into it after 60s.
    Replaces the idle dashboard and its attract-mode snake. The daemon now
    sends today's counts and a 5-hour usage series from one transcript scan.
    [base.py]
2026-09-27 Add mascot life scenes to ambient mode
    One room through the day: coffee, wandering, reading, the night sky,
    asleep. Adds a face helper for look direction and closed eyes, which also
    fixes the READY blink that never covered the pupils.
    [test_life.py]
2026-09-27 Launcher icons and 2-player Pong
    The app launcher is now a carousel of pixel-art icons instead of letters.
    Pong gets a mode picker: 2 players is joystick versus the encoder knob,
    first to 7. The main loop now sums every encoder detent per frame, so
    fast turns no longer drop steps (Breakout's paddle uses it too).
    [test_pong.py]
2026-09-27 Bring the README up to date with the current hardware and software
2026-09-27 Run the PCA9685 open-drain and write out MCP23017 #2's pins
    A 3.3V totem-pole high leaks through lamps sinking from 5V and breaks the
    meters' 5V drive. Open-drain fixes both with a 1k pull-up per meter from
    the resistor kit already ordered.
2026-09-27 Write the real panel driver and the HID gadget writer
    Thin drivers for the PCA9685 (open-drain, meters inverted), both
    MCP23017s, the ADS1115 and the WS2812 strip over SPI, plus gpiod edges for
    the buttons, mushroom and encoder. Input decoding is pure and tested
    against fake buses. Presses on the real panel also go out as their
    F13-F20 key. Mech keys pressed inside a game no longer reach Claude: NEW
    used to start a session while it was dropping a Tetris piece.
    [ads1115.py, base.py, fakes.py, gpio.py, inputs.py, mcp23017.py]
2026-09-27 Add deck provisioning: USB gadget, services, read-only root
    setup.sh provisions Radxa's Debian image: an unprivileged deck user with
    udev access to just the panel's devices, app and venv on /var/deck, the
    USB link with a one-address DHCP server and no route, key-only SSH on the
    link, radios off, and overlayroot. The HID gadget's descriptor declares
    only F13-F20. deploy.ps1 pushes updates over the link. The encoder's long
    press now actually powers the deck off.
2026-09-27 Make Settings > wifi radio actually switch WiFi
    rfkill through a sudoers entry for exactly block and unblock wifi, applied
    when flipped and again at start-up since WiFi is blocked every boot. The
    right rail shows a red WIFI tag while it's on. If rfkill refuses, the
    setting reverts instead of claiming WiFi is on.
    [test_radio.py]
2026-09-27 Rebuild the BOM arrivals tracker from the real order confirmations
